newtonsewingstudio-star/ayab-hardware/ayab-esp32/KH910_REV_A_HALL_ASTAR_ROUTE.md

# Hall ADC A* route report

grid: 0.25 mm; track: 0.25 mm; obstacle expansion: 0.22 mm

## /ESP32/HALL_R_ADC
- start: (309.5, 160.5)
- goal: (218.8, 134.13)
- A* cells: 365
- simplified segments: 9
- points: (309.500,160.500) -> (307.750,160.500) -> (307.250,161.000) -> (288.250,161.000) -> (274.000,146.750) -> (235.250,146.750) -> (223.250,134.750) -> (219.000,134.750) -> (219.000,134.500) -> (218.800,134.130)

## /ESP32/HALL_L_ADC
- start: (94.0, 136.5)
- goal: (219.55, 134.13)
- A* cells: 506
- simplified segments: 5
- points: (94.000,136.500) -> (207.000,136.500) -> (210.000,133.500) -> (219.500,133.500) -> (219.500,134.000) -> (219.550,134.130)
