newtonsewingstudio-star/ayab-hardware/ayab-esp32/KH910_REV_A_12V_BUS_AUDIT.md

# KH910 Rev A — Existing +12 V Bus Audit

## All footprint pads currently on +12V

| Ref | Value | Pad | X | Y | Type |
|---|---|---:|---:|---:|---|
| C302 | 10u | 1 | 109.625 | 142.275 | SMD |
| C303 | 10u | 1 | 122.175 | 142.275 | SMD |
| C304 | 10u | 1 | 97.050 | 142.275 | SMD |
| C601 | 10u | 1 | 305.870 | 120.900 | SMD |
| C603 | 10u | 1 | 97.058 | 136.362 | SMD |
| C604 | 10u | 1 | 109.625 | 136.375 | SMD |
| C605 | 10u | 1 | 122.175 | 136.375 | SMD |
| C606 | 220u | 1 | 301.427 | 121.742 | TH |
| C607 | 220u | 1 | 333.720 | 126.740 | TH |
| C610 | 10u | 1 | 305.904 | 126.300 | SMD |
| D601 | KMB14F | 3 | 300.860 | 158.970 | SMD |
| J401 | 900.965.CK35 SOLENOIDS A | 10 | 114.840 | 153.785 | TH |
| J401 | 900.965.CK35 SOLENOIDS A | 9 | 116.840 | 153.785 | TH |
| J403 | 910.950 SOLENOIDS A | 10 | 308.410 | 138.830 | TH |
| J403 | 910.950 SOLENOIDS A | 9 | 310.910 | 138.830 | TH |
| J406 | 930.940 SOLENOIDS A | 10 | 116.740 | 146.280 | TH |
| J406 | 930.940 SOLENOIDS A | 9 | 119.240 | 146.280 | TH |
| J602 | Brother_5P | 2 | 60.900 | 100.920 | TH |
| J604 | Brother_4R | 1 | 343.950 | 166.165 | TH |
| R603 | 10k | 1 | 304.791 | 161.550 | SMD |
| TP601 | 12V | 1 | 305.320 | 149.980 | SMD |
| U302 | ULN2003A | 9 | 132.895 | 136.850 | SMD |
| U303 | ULN2003A | 9 | 120.345 | 136.850 | SMD |
| U304 | ULN2003A | 9 | 107.795 | 136.850 | SMD |
| U601 | XL1509 | 1 | 308.254 | 124.445 | SMD |

## +12V zones

- none

## +12V segment endpoints with degree 1 (possible branch/source ends)

- B.Cu (64.900,140.320)
- F.Cu (97.050,140.375)
- F.Cu (97.058,138.262)
- F.Cu (98.905,141.800)
- F.Cu (109.625,138.275)
- F.Cu (109.625,140.375)
- F.Cu (111.455,141.800)
- B.Cu (114.030,139.330)
- F.Cu (114.840,153.785)
- F.Cu (116.740,146.280)
- B.Cu (116.840,153.785)
- B.Cu (116.840,163.100)
- B.Cu (119.240,146.280)
- F.Cu (122.175,138.275)
- F.Cu (122.175,140.375)
- F.Cu (124.005,141.800)
- F.Cu (305.061,161.280)
- F.Cu (305.360,150.020)
- B.Cu (306.490,155.850)
- F.Cu (307.570,161.280)
- F.Cu (308.096,161.280)
- F.Cu (308.254,124.445)
- B.Cu (308.410,138.830)
- B.Cu (333.720,126.740)
- B.Cu (339.950,124.155)
