newtonsewingstudio-star/ayab-hardware/ayab-esp32/KH910_REV_A_SOLENOID_ROUTING_AUDIT.md

# KH910 Rev A — Solenoid Routing Audit

- max existing net number: **152**
- +12V segments: **90**
- +12V vias: **9**

## Target +12 V pads that must move to SOLENOID_12V_SW

| Ref | Pad | Global X | Global Y | Current net | Nearest +12V copper |
|---|---:|---:|---:|---|---:|
| J401 | 9 | 116.840 | 153.785 | `+12V` | 0.000 mm |
| J401 | 10 | 114.840 | 153.785 | `+12V` | 0.000 mm |
| J403 | 9 | 310.910 | 138.830 | `+12V` | 0.000 mm |
| J403 | 10 | 308.410 | 138.830 | `+12V` | 0.000 mm |
| J406 | 9 | 119.240 | 146.280 | `+12V` | 0.000 mm |
| J406 | 10 | 116.740 | 146.280 | `+12V` | 0.000 mm |
| U302 | 9 | 132.895 | 136.850 | `+12V` | 9.264 mm |
| U303 | 9 | 120.345 | 136.850 | `+12V` | 2.319 mm |
| U304 | 9 | 107.795 | 136.850 | `+12V` | 2.319 mm |

## +12V copper segments within 12 mm of any target pad

- `F.Cu` width 1.000: (117.910,139.320) -> (116.750,139.320)
- `F.Cu` width 0.250: (303.400,151.970) -> (305.320,150.050)
- `F.Cu` width 0.250: (305.320,150.050) -> (305.320,149.980)
- `F.Cu` width 0.250: (124.005,139.455) -> (123.870,139.320)
- `F.Cu` width 0.250: (122.175,139.335) -> (122.160,139.320)
- `F.Cu` width 1.000: (109.790,139.320) -> (99.120,139.320)
- `F.Cu` width 0.250: (109.625,139.485) -> (109.790,139.320)
- `F.Cu` width 1.270: (119.240,149.210) -> (119.240,146.280)
- `F.Cu` width 0.250: (111.455,139.375) -> (111.510,139.320)
- `F.Cu` width 1.270: (116.840,153.785) -> (116.840,151.610)
- `F.Cu` width 1.000: (117.950,139.320) -> (117.930,139.300)
- `F.Cu` width 1.000: (116.740,139.310) -> (116.730,139.320)
- `F.Cu` width 0.250: (97.058,138.920) -> (97.058,139.052)
- `F.Cu` width 0.250: (97.050,140.375) -> (97.050,138.928)
- `F.Cu` width 1.000: (99.120,139.320) -> (96.790,139.320)
- `F.Cu` width 1.000: (122.160,139.320) -> (117.950,139.320)
- `F.Cu` width 0.250: (97.050,138.928) -> (97.058,138.920)
- `F.Cu` width 1.000: (116.750,139.320) -> (116.740,139.310)
- `F.Cu` width 0.250: (122.175,140.375) -> (122.175,139.335)
- `F.Cu` width 0.250: (97.058,138.262) -> (97.058,138.920)
- `F.Cu` width 1.270: (116.740,146.280) -> (119.240,146.280)
- `F.Cu` width 0.250: (109.625,138.275) -> (109.625,139.155)
- `F.Cu` width 1.000: (114.390,139.320) -> (111.510,139.320)
- `F.Cu` width 1.000: (117.930,139.300) -> (117.910,139.320)
- `F.Cu` width 0.250: (305.320,149.980) -> (305.360,150.020)
- `F.Cu` width 0.250: (122.175,138.275) -> (122.175,139.305)
- `F.Cu` width 1.270: (116.840,151.610) -> (119.240,149.210)
- `F.Cu` width 1.000: (116.730,139.320) -> (115.600,139.320)
- `F.Cu` width 1.000: (123.870,139.320) -> (122.160,139.320)
- `F.Cu` width 1.000: (115.600,139.320) -> (114.390,139.320)
- `F.Cu` width 1.270: (116.840,153.785) -> (114.840,153.785)
- `F.Cu` width 0.250: (109.625,139.155) -> (109.790,139.320)
- `F.Cu` width 0.250: (122.175,139.305) -> (122.160,139.320)
- `F.Cu` width 0.250: (109.625,140.375) -> (109.625,139.485)
- `F.Cu` width 1.000: (111.510,139.320) -> (109.790,139.320)
- `F.Cu` width 0.250: (97.058,139.052) -> (96.790,139.320)
- `F.Cu` width 0.250: (124.005,141.800) -> (124.005,139.455)
- `F.Cu` width 0.250: (98.905,141.800) -> (98.905,139.535)
- `F.Cu` width 0.250: (98.905,139.535) -> (99.120,139.320)
- `F.Cu` width 0.250: (111.455,141.800) -> (111.455,139.375)
- `B.Cu` width 2.000: (310.910,138.830) -> (308.410,138.830)
- `B.Cu` width 1.270: (116.840,153.785) -> (116.840,163.100)
- `B.Cu` width 1.270: (118.470,139.330) -> (114.030,139.330)
- `B.Cu` width 1.270: (119.243,140.103) -> (118.470,139.330)
- `B.Cu` width 1.270: (70.500,163.100) -> (303.530,163.100)
- `B.Cu` width 1.270: (334.160,141.850) -> (312.450,141.850)
- `B.Cu` width 1.270: (119.243,146.277) -> (119.243,140.103)
- `B.Cu` width 1.270: (312.450,141.850) -> (310.910,140.310)
- `B.Cu` width 1.270: (119.240,146.280) -> (119.243,146.277)
- `B.Cu` width 1.270: (310.910,140.310) -> (310.910,138.830)

## Existing +12V vias near target pads

- via (117.930,139.300) size 0.800 drill 0.400
- via (115.600,139.320) size 0.800 drill 0.400
- via (114.390,139.320) size 0.800 drill 0.400
- via (116.740,139.310) size 0.800 drill 0.400

## Existing MOSFET footprint templates

### Q201 — AO3400A / C20917
- footprint `Package_TO_SOT_SMD:SOT-23` at (240.7725, 152.37, 0.0)
- pad 1 global (239.835,151.420) net `/ESP32/BUZZER`
- pad 2 global (239.835,153.320) net `GND`
- pad 3 global (241.710,152.370) net `Net-(Q201-D)`

### Q502 — LP9435LT1G / C383257
- footprint `Package_TO_SOT_SMD:SOT-23` at (258.45, 154.035, 90.0)
- pad 1 global (259.400,153.097) net `Net-(Q501B-C2)`
- pad 2 global (257.500,153.097) net `+5V`
- pad 3 global (258.450,154.972) net `Net-(Q501A-E1)`

### Q801 — AO3400A / C20917
- footprint `Package_TO_SOT_SMD:SOT-23` at (275.5746, 155.0175, -90.0)
- pad 1 global (274.625,155.955) net `+3V3`
- pad 2 global (276.525,155.955) net `Net-(Q801-S)`
- pad 3 global (275.575,154.080) net `/AUX-CONNECTORS/AUX_SCL`

### Q802 — AO3400A / C20917
- footprint `Package_TO_SOT_SMD:SOT-23` at (280.615, 155.0475, -90.0)
- pad 1 global (279.665,155.985) net `+3V3`
- pad 2 global (281.565,155.985) net `Net-(Q802-S)`
- pad 3 global (280.615,154.110) net `/AUX-CONNECTORS/AUX_SDA`

### Q803 — AO3400A / C20917
- footprint `Package_TO_SOT_SMD:SOT-23` at (94.23, 127.32, 90.0)
- pad 1 global (95.180,126.382) net `+3V3`
- pad 2 global (93.280,126.382) net `Net-(Q803-S)`
- pad 3 global (94.230,128.257) net `/AUX-CONNECTORS/MCP_SCL`

### Q804 — AO3400A / C20917
- footprint `Package_TO_SOT_SMD:SOT-23` at (97.75, 127.33, 90.0)
- pad 1 global (98.700,126.392) net `+3V3`
- pad 2 global (96.800,126.392) net `Net-(Q804-S)`
- pad 3 global (97.750,128.267) net `/AUX-CONNECTORS/MCP_SDA`

## New schematic device paths

- Q805: `/ad16b75f-afc8-4717-a7c6-8dd7b69a18e2/5c12a608-dfd1-46fe-96db-4ec512a20774`
- Q806: `/ad16b75f-afc8-4717-a7c6-8dd7b69a18e2/5c12a608-dfd1-46fe-96db-4ec512a20774`
- R820: `/ad16b75f-afc8-4717-a7c6-8dd7b69a18e2/5c12a608-dfd1-46fe-96db-4ec512a20774`
- R821: `/ad16b75f-afc8-4717-a7c6-8dd7b69a18e2/5c12a608-dfd1-46fe-96db-4ec512a20774`
- R822: `/ad16b75f-afc8-4717-a7c6-8dd7b69a18e2/5c12a608-dfd1-46fe-96db-4ec512a20774`

## Coarse board edge bounds

- X: 60.224 .. 345.346
- Y: 116.112 .. 164.214
