newtonsewingstudio-star/ayab-hardware/firmware/stage5/BETA_STATUS.md

# Stage 5 beta — ESP32-S3 KH910 Rev A

Status: **experimental development snapshot, not machine-ready**.

Source hardware: `newtonsewingstudio-star/ayab-hardware` commit `ae8f7eb`.

This directory contains an exact source and test backup of the Stage 5 working archive. There are 20 original project files: the PlatformIO project file, 6 `src/` files, 8 `tests/` files, and 5 project documentation files. The snapshot has protocol and simulation tests, but does **not** have a verified ESP32-S3 target build or validated hardware drivers. All machine-output functionality must remain disabled until electrical and physical safety checks are completed.

See `BUILD_STATUS.md` and `BENCH_TEST_PLAN.md` before bench testing. GitHub files were individually checked against the local Stage 5 snapshot using Git blob SHA-1 checksums.
