newtonsewingstudio-star/ayab-hardware/ayab-esp32/review/KH910_REV_A_AUDIT_ROUND_2.md

# AYAB KH910 Rev A — External Audit Round 2 Record

Review input: external static review of the `09fa402` handoff package.

Record status: structured author-maintained summary of the auditor's response. It is not represented as a verbatim transcript or as an independently executed KiCad review.

## Package integrity

- The auditor re-verified all 222 entries in `MANIFEST_SHA256.txt`; every file hash matched.
- No tamper evidence was found.
- The auditor could not independently reach the GitHub repository or CI runs from the available environment, so the packaged CI evidence remains self-supplied from the auditor's perspective.

## Prior findings

| Finding | Round 2 assessment |
|---|---|
| P1: GPIO4 exposed if R216 opens | Closed. D205/D206/C206 and R215 were confirmed in the schematic, and the clamp-current limits were accepted as sound for the prototype scope. |
| P1: divider transient margin thin | Closed for prototype scope. Ordinary positive and negative excursions are bounded, while surge certification and stated residual faults remain explicitly excluded. |
| P2: solenoid-gate fault tree incomplete | Closed. All eleven requested component/control fault cases and the unsafe residuals are enumerated. |
| P2: I/O-map authority conflict | Closed. The prose map is explicitly subordinate to native KiCad and the generated pin audit. |
| P3: iterative tooling/self-audit provenance | Acknowledged and mitigated, not erased. Independent re-derivation remains important. |
| P3: PASS wording could be misread | Closed editorially. The design-review verdict retains its one-prototype, supervised-bring-up, and non-certification limits. |

## New documentation correction

The prior handoff described `AUDITOR_NOTES_e3dd936.md` as preserving the preliminary review “verbatim.” It was a paraphrased and restructured summary. This record and all refreshed handoff materials describe it accurately as a faithful structured summary.

## Remaining gates

1. Before fabrication: an independent reviewer with KiCad must reproduce DRC, ERC, pin-map, topology, and parity checks from the native source. The author-generated CI evidence does not substitute for that independent run.
2. After assembly and before any solenoid is attached or operated: perform the documented rail, isolation, ADC/transient, reset/brownout, current, and thermal measurements.

No fabrication files were produced for this audit cycle.
