newtonsewingstudio-star/ayab-hardware/ayab-esp32/review/KH910_REV_A_POWER_LAYOUT.md

# KH910 Rev A — Power PCB Placement Preflight

Read-only KiCad-native inventory used before adding U403 and R215/R216.

## Existing power-stage footprints and pads

### C612 — `220u` at (301.504, 129.134)
- pad 1 (301.504, 129.134): `/PSU/5V_SW`
- pad 2 (299.004, 129.134): `GND`

### C613 — `220u` at (268.260, 128.930)
- pad 1 (268.260, 128.930): `/PSU/3V3_SW`
- pad 2 (265.760, 128.930): `GND`

### C614 — `3n3` at (307.920, 130.620)
- pad 1 (307.920, 129.845): `Net-(U601-FB)`
- pad 2 (307.920, 131.395): `/PSU/5V_SW`

### C615 — `3n3` at (274.660, 130.630)
- pad 1 (274.660, 129.855): `Net-(U602-FB)`
- pad 2 (274.660, 131.405): `/PSU/3V3_SW`

### C616 — `10u` at (313.740, 130.830)
- pad 1 (313.740, 131.780): `/PSU/5V_SW`
- pad 2 (313.740, 129.880): `GND`

### C617 — `10u` at (280.560, 130.840)
- pad 1 (280.560, 131.790): `/PSU/3V3_SW`
- pad 2 (280.560, 129.890): `GND`

### C618 — `10u` at (311.720, 130.830)
- pad 1 (311.720, 131.780): `/PSU/5V_SW`
- pad 2 (311.720, 129.880): `GND`

### C619 — `10u` at (278.510, 130.840)
- pad 1 (278.510, 131.790): `/PSU/3V3_SW`
- pad 2 (278.510, 129.890): `GND`

### C620 — `10u` at (309.690, 130.840)
- pad 1 (309.690, 131.790): `/PSU/5V_SW`
- pad 2 (309.690, 129.890): `GND`

### C621 — `10u` at (276.460, 130.850)
- pad 1 (276.460, 131.800): `/PSU/3V3_SW`
- pad 2 (276.460, 129.900): `GND`

### D605 — `SS54` at (311.054, 121.800)
- pad 1 (313.054, 121.800): `Net-(D605-K)`
- pad 2 (309.054, 121.800): `GND`

### D606 — `SS54` at (278.059, 121.800)
- pad 1 (280.059, 121.800): `Net-(D606-K)`
- pad 2 (276.059, 121.800): `GND`

### L601 — `47uH` at (321.380, 126.320)
- pad 1 (321.380, 121.370): `Net-(D605-K)`
- pad 2 (321.380, 131.270): `/PSU/5V_SW`

### L602 — `47uH` at (288.284, 126.325)
- pad 1 (288.284, 121.375): `Net-(D606-K)`
- pad 2 (288.284, 131.275): `/PSU/3V3_SW`

### R606 — `1k` at (304.830, 130.620)
- pad 1 (304.830, 131.445): `Net-(U601-FB)`
- pad 2 (304.830, 129.795): `GND`

### R607 — `1k` at (271.570, 130.630)
- pad 1 (271.570, 131.455): `Net-(U602-FB)`
- pad 2 (271.570, 129.805): `GND`

### R608 — `3k3` at (306.380, 130.620)
- pad 1 (306.380, 129.795): `Net-(U601-FB)`
- pad 2 (306.380, 131.445): `/PSU/5V_SW`

### R609 — `1k8` at (273.110, 130.630)
- pad 1 (273.110, 129.805): `Net-(U602-FB)`
- pad 2 (273.110, 131.455): `/PSU/3V3_SW`

### R610 — `0R` at (276.950, 134.870)
- pad 1 (276.125, 134.870): `/PSU/3V3_SW`
- pad 2 (277.775, 134.870): `+3V3`

- R611: **missing**
### TP602 — `5V` at (306.863, 134.518)
- pad 1 (306.863, 134.518): `/PSU/5V_SW`

### TP603 — `3V3` at (273.837, 134.518)
- pad 1 (273.837, 134.518): `/PSU/3V3_SW`

### U601 — `XL1509` at (310.729, 126.350)
- pad 1 (308.254, 124.445): `+12V`
- pad 2 (308.254, 125.715): `Net-(D605-K)`
- pad 3 (308.254, 126.985): `Net-(U601-FB)`
- pad 4 (308.254, 128.255): `GND`
- pad 5 (313.204, 128.255): `GND`
- pad 6 (313.204, 126.985): `GND`
- pad 7 (313.204, 125.715): `GND`
- pad 8 (313.204, 124.445): `GND`

### U602 — `XL1509` at (277.859, 126.330)
- pad 1 (275.384, 124.425): `+5V`
- pad 2 (275.384, 125.695): `Net-(D606-K)`
- pad 3 (275.384, 126.965): `Net-(U602-FB)`
- pad 4 (275.384, 128.235): `GND`
- pad 5 (280.334, 128.235): `GND`
- pad 6 (280.334, 126.965): `GND`
- pad 7 (280.334, 125.695): `GND`
- pad 8 (280.334, 124.425): `GND`

## Existing GPIO4 branch to be removed

- U201 pad 8 / GPIO4 at (217.125, 129.675): `/ESP32/MACHINE_PWR_SENSE`
- Routed items ending directly at that pad:
  - `/ESP32/MACHINE_PWR_SENSE` F.Cu (209.785, 129.675) -> (217.125, 129.675)

## Nearby placement inventory

### Within 18 mm of U201 at (224.125, 129.675)
- 11.20 mm: R818 `47R` at (235.325, 129.910)
- 11.28 mm: R208 `10k` at (235.325, 128.350)
- 11.33 mm: R819 `47R` at (235.315, 131.460)
- 11.51 mm: R206 `10k` at (212.750, 127.950)
- 11.57 mm: R207 `10k` at (235.325, 126.775)
- 11.62 mm: R210 `5k1` at (212.750, 132.025)
- 11.77 mm: C201 `100n` at (235.300, 133.370)
- 11.84 mm: C203 `100n` at (212.750, 126.400)
- 12.06 mm: R209 `5k1` at (212.750, 133.675)
- 12.06 mm: C202 `100n` at (235.325, 125.200)
- 12.34 mm: R201 `10k` at (235.300, 134.920)
- 12.35 mm: C204 `100n` at (212.750, 124.875)
- 12.70 mm: R814 `10k` at (212.750, 135.325)
- 12.71 mm: R205 `10k` at (235.320, 123.650)
- 13.35 mm: C205 `10u` at (212.525, 123.075)
- 13.52 mm: R813 `47R` at (212.750, 136.975)
- 14.46 mm: R815 `10k` at (212.750, 138.600)
- 14.84 mm: D201 `LED_YEL` at (238.692, 132.490)
- 15.40 mm: D202 `LED_GRN` at (238.692, 134.680)
- 16.26 mm: D203 `LED_RED` at (238.692, 136.890)
- 17.15 mm: FID102 `Fiducial` at (240.990, 126.580)

### Within 18 mm of U601 at (310.729, 126.350)
- 4.56 mm: D605 `SS54` at (311.054, 121.800)
- 4.59 mm: C618 `10u` at (311.720, 130.830)
- 4.61 mm: C620 `10u` at (309.690, 130.840)
- 4.93 mm: C610 `10u` at (305.904, 125.350)
- 5.11 mm: C614 `3n3` at (307.920, 130.620)
- 5.40 mm: C616 `10u` at (313.740, 130.830)
- 6.10 mm: R608 `3k3` at (306.380, 130.620)
- 6.62 mm: C601 `10u` at (305.870, 121.850)
- 7.03 mm: R604 `5k1` at (310.120, 133.350)
- 7.28 mm: R606 `1k` at (304.830, 130.620)
- 7.42 mm: D603 `5VOK` at (313.160, 133.360)
- 9.04 mm: TP602 `5V` at (306.863, 134.518)
- 9.64 mm: C612 `220u` at (301.504, 129.134)
- 10.17 mm: kibuzzard-659F49E4 `G***` at (304.673, 134.518)
- 10.38 mm: C606 `220u` at (301.427, 121.742)
- 10.65 mm: L601 `47uH` at (321.380, 126.320)
- 14.44 mm: kibuzzard-65BFD836 `G***` at (322.150, 135.180)
- 16.11 mm: J403 `910.950 SOLENOIDS A` at (320.910, 138.830)

## Required staged edits

- Place U403 adjacent to the U601 filtered-output cluster, then partition only that output from the existing +5V copper.
- Place R215/R216 beside U201 GPIO4, route the divider locally, and leave the high-voltage +12V segment away from USB/data routing.
- Refill zones and prove DRC, connectivity, and the power-state topology before promotion.
