newtonsewingstudio-star/ayab-hardware/ayab-esp32/KH910_REV_A_FAILSAFE_LAYOUT_AUDIT.md

# KH910 Rev A — Fail-Safe Layout Corridor Audit

## Right-side placement region (X 260..320, Y 145..162)

- R807 `5k1` at (273.065,155.475) rot 90
- J405 `910.950 ENCODERS EOL R` at (280.930,145.170) rot 180
- TP401 `9` at (270.930,149.150) rot 0
- TP402 `10` at (268.420,149.140) rot 0
- R734 `47k` at (313.120,157.250) rot 90
- R730 `4k7` at (311.570,157.250) rot -90
- J601 `VIN` at (292.105,156.085) rot 90
- kibuzzard-65C3D944 `G***` at (307.380,149.980) rot 0
- FID106 `Fiducial` at (266.540,153.040) rot 0
- R801 `47R` at (273.065,152.425) rot -90
- R721 `10k` at (313.120,154.200) rot 90
- R804 `5k1` at (275.375,152.280) rot 0
- R803 `5k1` at (280.390,152.310) rot 180
- Q802 `AO3400A` at (280.615,155.048) rot -90
- Q801 `AO3400A` at (275.575,155.018) rot -90
- R729 `3k3` at (311.570,154.200) rot -90
- D601 `KMB14F` at (302.130,156.150) rot 90
- kibuzzard-659F41CB `G***` at (269.850,160.230) rot 0
- J802 `I2C_VBUS` at (281.500,159.360) rot -90
- R808 `5k1` at (278.090,155.485) rot 90
- R732 `22k` at (314.670,157.250) rot -90
- U703 `LM393` at (319.195,155.400) rot 0
- J803 `USER_I2C` at (276.250,160.335) rot 0
- TP601 `12V` at (305.320,149.980) rot -90
- kibuzzard-65A1ADEE `G***` at (318.240,160.160) rot 0
- R717 `100k` at (314.670,154.200) rot -90
- R802 `47R` at (278.090,152.435) rot -90
- R603 `10k` at (303.966,161.550) rot 180

## Pads currently on GPIO21 PCB net 148

- J202 pad 4 at (119.000,120.300) `/ESP32/ESP21`
- U201 pad 25 at (225.825,136.675) `/ESP32/ESP21`

## Solenoid-sheet +12V pads expected to become switched

- C303 pad 1 at (122.175,142.275)
- U304 pad 9 at (107.795,136.850)
- U303 pad 9 at (120.345,136.850)
- C302 pad 1 at (109.625,142.275)
- J401 pad 9 at (116.840,153.785)
- J401 pad 10 at (114.840,153.785)
- J406 pad 9 at (119.240,146.280)
- J406 pad 10 at (116.740,146.280)
- J403 pad 9 at (310.910,138.830)
- J403 pad 10 at (308.410,138.830)
- U302 pad 9 at (132.895,136.850)
- C304 pad 1 at (97.050,142.275)

## Copper in proposed switched-bus corridor (X 90..320, Y 158.5..162.2)

- F.Cu net 2 w 0.250: (161.840,159.750)->(161.860,159.730)
- F.Cu net 2 w 0.250: (161.860,159.730)->(161.860,157.115)
- F.Cu net 4 w 1.270: (306.490,159.020)->(306.490,155.850)
- F.Cu net 4 w 1.270: (306.490,160.160)->(306.490,159.060)
- F.Cu net 4 w 1.270: (308.160,161.870)->(309.310,163.020)
- F.Cu net 4 w 0.250: (308.096,161.280)->(305.061,161.280)
- F.Cu net 4 w 1.270: (308.160,161.870)->(306.470,160.180)
- F.Cu net 4 w 1.270: (306.490,159.060)->(306.470,159.040)
- F.Cu net 4 w 1.270: (306.470,160.180)->(306.490,160.160)
- F.Cu net 4 w 1.270: (308.160,161.870)->(307.570,161.280)
- F.Cu net 4 w 1.270: (306.470,159.040)->(306.490,159.020)
- B.Cu net 4 w 1.270: (306.490,160.140)->(306.490,155.850)
- B.Cu net 4 w 1.270: (116.840,153.785)->(116.840,163.100)
- B.Cu net 4 w 1.270: (303.530,163.100)->(306.490,160.140)
- F.Cu net 5 w 0.250: (281.500,160.660)->(283.110,160.660)
- F.Cu net 5 w 0.250: (182.809,161.159)->(182.810,161.160)
- F.Cu net 5 w 0.250: (181.713,161.159)->(182.809,161.159)
- F.Cu net 5 w 0.250: (182.810,159.590)->(182.758,159.538)
- F.Cu net 5 w 0.250: (182.758,159.538)->(181.713,159.538)
- In2.Cu net 5 w 1.000: (181.420,162.550)->(182.810,161.160)
- In2.Cu net 5 w 1.000: (284.610,159.160)->(284.610,151.670)
- In2.Cu net 5 w 1.000: (163.840,159.750)->(166.640,162.550)
- In2.Cu net 5 w 1.000: (268.100,160.660)->(283.110,160.660)
- In2.Cu net 5 w 1.000: (283.110,160.660)->(284.610,159.160)
- In2.Cu net 5 w 1.000: (259.410,151.970)->(268.100,160.660)
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
- F.Cu w 1.270: (305.360,153.690)->(306.490,154.820)
- F.Cu w 1.270: (305.030,153.360)->(305.360,153.690)
- F.Cu w 1.270: (306.470,159.040)->(306.490,159.020)
- B.Cu w 1.270: (306.490,160.140)->(306.490,155.850)
- B.Cu w 1.270: (303.530,163.100)->(306.490,160.140)
