newtonsewingstudio-star/ayab-hardware/ayab-esp32/KH910_REV_A_HALL_LEGACY_ROUTES.md

# KH910 Rev A — Legacy Hall Route Audit

Total items: **26**

The baseline PCB is DRC-clean. These are the exact legacy EOL_L_P/EOL_L_N copper items before Hall migration.

## /ESP32/EOL_L_P — 12 items

1. `F.Cu` segment (219.55, 128.83) -> (217.845, 127.125)
2. `F.Cu` segment (217.845, 127.125) -> (217.125, 127.125)
3. `F.Cu` segment (212.04, 156.36) -> (213.824898, 156.36)
4. `F.Cu` segment (210.545, 157.855) -> (212.04, 156.36)
5. `F.Cu` segment (213.824898, 156.36) -> (215.127498, 155.0574)
6. `F.Cu` segment (197.2025, 157.855) -> (210.545, 157.855)
7. `F.Cu` segment (219.55, 134.13) -> (219.55, 128.83)
8. `B.Cu` segment (218.72, 135.79) -> (218.72, 151.464898)
9. `B.Cu` segment (218.72, 151.464898) -> (215.127498, 155.0574)
10. `B.Cu` segment (219.55, 134.96) -> (218.72, 135.79)
11. `B.Cu` segment (219.55, 134.13) -> (219.55, 134.96)
12. `F.Cu-B.Cu` via at (219.55, 134.13)

### MCU-near subset (x >= 205 or y <= 145)

- item 1: `F.Cu` segment (219.55, 128.83) -> (217.845, 127.125)
- item 2: `F.Cu` segment (217.845, 127.125) -> (217.125, 127.125)
- item 3: `F.Cu` segment (212.04, 156.36) -> (213.824898, 156.36)
- item 4: `F.Cu` segment (210.545, 157.855) -> (212.04, 156.36)
- item 5: `F.Cu` segment (213.824898, 156.36) -> (215.127498, 155.0574)
- item 6: `F.Cu` segment (197.2025, 157.855) -> (210.545, 157.855)
- item 7: `F.Cu` segment (219.55, 134.13) -> (219.55, 128.83)
- item 8: `B.Cu` segment (218.72, 135.79) -> (218.72, 151.464898)
- item 9: `B.Cu` segment (218.72, 151.464898) -> (215.127498, 155.0574)
- item 10: `B.Cu` segment (219.55, 134.96) -> (218.72, 135.79)
- item 11: `B.Cu` segment (219.55, 134.13) -> (219.55, 134.96)
- item 12: `F.Cu-B.Cu` via at (219.55, 134.13)

## /ESP32/EOL_L_N — 14 items

1. `F.Cu` segment (218.8, 128.93) -> (217.845, 127.975)
2. `F.Cu` segment (218.8, 134.13) -> (218.8, 128.93)
3. `F.Cu` segment (197.2025, 158.505) -> (211.679898, 158.505)
4. `F.Cu` segment (217.845, 127.975) -> (217.125, 127.975)
5. `F.Cu` segment (211.679898, 158.505) -> (212.587498, 157.5974)
6. `B.Cu` segment (218.47, 135.63) -> (218.47, 151.041244)
7. `B.Cu` segment (218.47, 151.041244) -> (215.731244, 153.78)
8. `B.Cu` segment (213.88, 156.304898) -> (212.587498, 157.5974)
9. `B.Cu` segment (213.88, 154.43) -> (213.88, 156.304898)
10. `B.Cu` segment (215.731244, 153.78) -> (214.53, 153.78)
11. `B.Cu` segment (218.8, 134.13) -> (218.8, 135.3)
12. `B.Cu` segment (218.8, 135.3) -> (218.47, 135.63)
13. `B.Cu` segment (214.53, 153.78) -> (213.88, 154.43)
14. `F.Cu-B.Cu` via at (218.8, 134.13)

### MCU-near subset (x >= 205 or y <= 145)

- item 1: `F.Cu` segment (218.8, 128.93) -> (217.845, 127.975)
- item 2: `F.Cu` segment (218.8, 134.13) -> (218.8, 128.93)
- item 3: `F.Cu` segment (197.2025, 158.505) -> (211.679898, 158.505)
- item 4: `F.Cu` segment (217.845, 127.975) -> (217.125, 127.975)
- item 5: `F.Cu` segment (211.679898, 158.505) -> (212.587498, 157.5974)
- item 6: `B.Cu` segment (218.47, 135.63) -> (218.47, 151.041244)
- item 7: `B.Cu` segment (218.47, 151.041244) -> (215.731244, 153.78)
- item 8: `B.Cu` segment (213.88, 156.304898) -> (212.587498, 157.5974)
- item 9: `B.Cu` segment (213.88, 154.43) -> (213.88, 156.304898)
- item 10: `B.Cu` segment (215.731244, 153.78) -> (214.53, 153.78)
- item 11: `B.Cu` segment (218.8, 134.13) -> (218.8, 135.3)
- item 12: `B.Cu` segment (218.8, 135.3) -> (218.47, 135.63)
- item 13: `B.Cu` segment (214.53, 153.78) -> (213.88, 154.43)
- item 14: `F.Cu-B.Cu` via at (218.8, 134.13)
