newtonsewingstudio-star/ayab-hardware/ayab-esp32/review/KH910_REV_A_BOTTOM.png

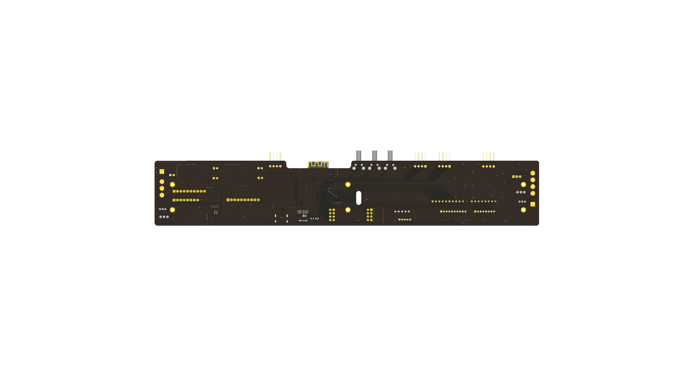
ayab-esp32/review/KH910_REV_A_BOTTOM.png
