newtonsewingstudio-star/ayab-hardware/ayab-esp32/review/KH910_REV_A_BOTTOM_COPPER.png

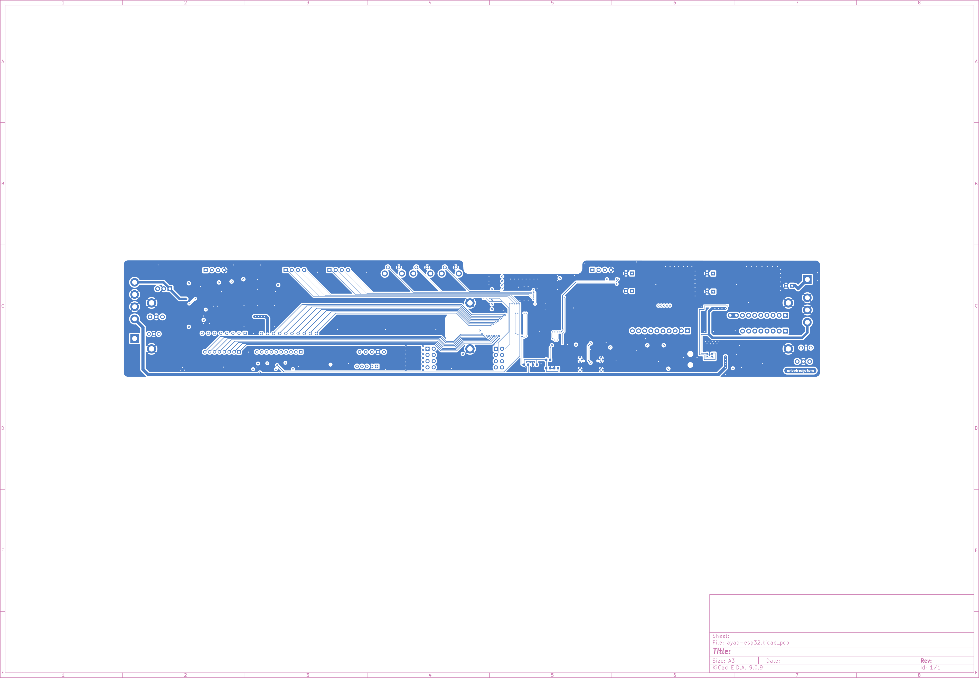
ayab-esp32/review/KH910_REV_A_BOTTOM_COPPER.png
