newtonsewingstudio-star/ayab-hardware/ayab-esp32/ayab-esp32.kicad_pcb

## KiCad design ayab-esp32/ayab-esp32.kicad_pcb (2026-09-15)

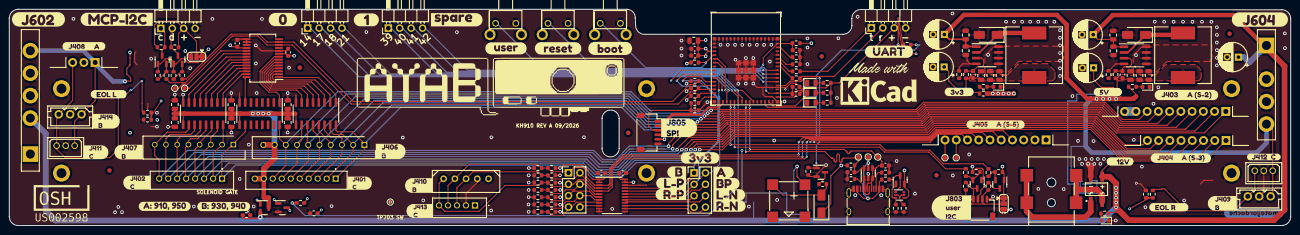
[picture p3: board ayab-esp32.kicad_pcb from above]

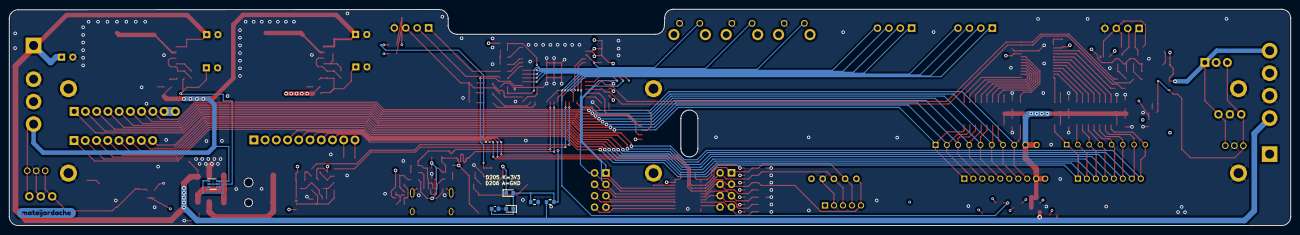
[picture p4: board ayab-esp32.kicad_pcb from below]

Board: 4 copper layers, 285.1 x 48.1 mm, 235 parts (7 on the bottom side), 128 nets.

Parts:
BUZZER201: MLT-8530; BUZ-SMD_4P-L8.5-W8.5-P8.50-BR
C201, C202, C203, C204, C206, C301, C305, C701, C702: 100n; C_0603_1608Metric
C205, C302, C303, C304, C601, C602, C603, C604, C605, C610, C611, C616, C617, C618, C619, C620, C621: 10u; C_0805_2012Metric
C501, C502: 47p; C_0603_1608Metric
C606, C607, C609, C612, C613: 220u; CP_Radial_D6.3mm_P2.50mm
C614, C615: 3n3; C_0603_1608Metric
D201: LED_YEL; D_0805_2012Metric
D202: LED_GRN; D_0805_2012Metric
D203: LED_RED; D_0805_2012Metric
D204, D605, D606: SS54; D_SMA
D205, D206: CDBU0130-HF; D_0603_1608Metric
D601: KMB14F; MBF-SMD_L4.8-W3.8-P2.54-LS6.8-TL
D602: 12VOK; D_0603_1608Metric
D603: 5VOK; D_0603_1608Metric
D604: 3V3OK; D_0603_1608Metric
FID101, FID102, FID103, FID104, FID105, FID106: Fiducial; Fiducial_1mm_Mask2mm
H101, H102, H103, H104, H106, H108: M2; MountingHole_2.2mm_M2_DIN965_Pad
J201: SPARE1; PinHeader_1x04_P2.54mm_Horizontal
J202: SPARE0; PinHeader_1x04_P2.54mm_Horizontal
J401: 900.965.CK35 SOLENOIDS A; 530141010
J402: 900.965.CK35 SOLENOIDS B; 530140810
J403: 910.950 SOLENOIDS A; HNC2-2.5P-10DS
J404: 910.950 SOLENOIDS B; HNC2-2.5P-8DS
J405: 910.950 ENCODERS EOL R; HNC2-2.5P-10DS
J406: 930.940 SOLENOIDS A; SHDR10W70P0X250_1X10_2740X490X590P
J407: 930.940 SOLENOIDS B; SHDR8W65P0X250_1X8_2240X490X610P
J408: 910.950 EOL L; HNC2-2.5P-3DS
J409: 930.940 EOL R; CONN-TH_3P-P2.50_X2564WV-03-N0SN
J410: 930.940 ENCODERS; CONN-TH_X2564WV-05-N0SN
J411: 900.965 EOL L; CONN-TH_3P-P2.00_A2004WV-3P
J412: 900.965 EOL R; CONN-TH_3P-P2.00_A2004WV-3P
J413: 900.965 ENCODERS; 530140510
J414: 930.940 EOL L; CONN-TH_3P-P2.50_X2564WV-03-N0SN
J501: USB_C_Receptacle_USB2.0; USB_C_Receptacle_HRO_TYPE-C-31-M-12
J601: VIN; DC-IN-TH_DC-005-5A-2.0-SMT
J602: Brother_5P
J604: Brother_4R; Brother_4P
J701: CTRL_3v3; PinHeader_2x04_P2.54mm_Vertical
J702: CTRL_5V; PinHeader_2x04_P2.54mm_Vertical
J801: AYAB_UART; PinHeader_1x04_P2.54mm_Horizontal
J802, J804: I2C_VBUS; SolderJumper-3_P1.3mm_Bridged12_RoundedPad1.0x1.5mm
J803: USER_I2C; JST_SH_SM04B-SRSS-TB_1x04-1MP_P1.00mm_Horizontal
J805: AYAB_SPI; JST_SH_SM06B-SRSS-TB_1x06-1MP_P1.00mm_Horizontal
J806: AYAB_I2C; PinHeader_1x04_P2.54mm_Horizontal
L601, L602: 47uH; L_12x12mm_H8mm
Q201, Q801, Q802, Q803, Q804, Q806: AO3400A; SOT-23
Q501: BCM857BV; SOT-363_SC-70-6
Q502, Q805: LP9435LT1G; SOT-23
R101, R102, R202, R203, R204, R209, R210, R604, R803, R804, R807, R808, R811, R812, R816, R817: 5k1; R_0603_1608Metric
R201, R205, R206, R207, R208, R211, R213, R214, R216, R603, R701, R702, R703, R704, R705, R706, R707, R708, R709, R710, R711, R712, R713, R714, R735, R736, R737, R738, R814, R815, R821: 10k; R_0603_1608Metric
R212, R504, R610: 0R; R_0603_1608Metric
R215: 47k; R_0603_1608Metric
R501: 1k5; R_0603_1608Metric
R502, R820, R822: 100k; R_0603_1608Metric
R503: 68k; R_0603_1608Metric
R605, R608: 3k3; R_0603_1608Metric
R606, R607: 1k; R_0603_1608Metric
R609: 1k8; R_0603_1608Metric
R801, R802, R809, R810, R813, R818, R819: 47R; R_0603_1608Metric
SW201: USER; KEY-TH_4P-L7.5-W11.5-P4.5
SW202: RESET; KEY-TH_4P-L7.5-W11.5-P4.5
SW203: BOOTSEL; KEY-TH_4P-L7.5-W11.5-P4.5
TP301: MCP_INTA; TestPoint_Pad_D1.0mm
TP302: MCP_INTB; TestPoint_Pad_D1.0mm
TP401: 9; TestPoint_Pad_D1.0mm
TP402: 10; TestPoint_Pad_D1.0mm
TP501: USB_BUSV; TestPoint_Pad_D1.0mm
TP502: USBM; TestPoint_Pad_D1.0mm
TP503: USBP; TestPoint_Pad_D1.0mm
TP601: 12V; TestPoint_Pad_D1.0mm
TP602: 5V; TestPoint_Pad_D1.0mm
TP603: 3V3; TestPoint_Pad_D1.0mm
TP701: HALL-L-RAW; TestPoint_Pad_D1.0mm
TP702: HALL-R-RAW; TestPoint_Pad_D1.0mm
TP703: SOL12_SW; TestPoint_Pad_D1.0mm
U201: ESP32-S3-MINI-1
U301: MCP23017_SS; SSOP-28_5.3x10.2mm_P0.65mm
U302, U303, U304: ULN2003A; SOIC-16_3.9x9.9mm_P1.27mm
U403: LM66100DCKR; SOT-363_SC-70-6
U501: SRV05-4; SOT-23-6
U601, U602: XL1509; SOIC-8_3.9x4.9mm_P1.27mm
U701: SN74LVC4245; TSSOP-24_4.4x7.8mm_P0.65mm
kibuzzard-64F68412: G***; kibuzzard-64F68412
kibuzzard-65A1AC88: G***; kibuzzard-65A1AC88
kibuzzard-65A1ADEE: G***; kibuzzard-65A1ADEE
kibuzzard-65A1DFCB: G***; kibuzzard-65A1DFCB
kibuzzard-65A2E0AA: G***; kibuzzard-65A2E0AA
kibuzzard-65A2E6F1: G***; kibuzzard-65A2E6F1
kibuzzard-65A2E096: G***; kibuzzard-65A2E096
kibuzzard-65A40139: G***; kibuzzard-65A40139
kibuzzard-65BC6282: G***; kibuzzard-65BC6282
kibuzzard-65BFAF9E: G***; kibuzzard-65BFAF9E
kibuzzard-65BFB941: G***; kibuzzard-65BFB941
kibuzzard-65BFD8A4: G***; kibuzzard-65BFD8A4
kibuzzard-65BFD8C0: G***; kibuzzard-65BFD8C0
kibuzzard-65BFD8D6: G***; kibuzzard-65BFD8D6
kibuzzard-65BFD8DF: G***; kibuzzard-65BFD8DF
kibuzzard-65BFD8F7: G***; kibuzzard-65BFD8F7
kibuzzard-65BFD82E: G***; kibuzzard-65BFD82E
kibuzzard-65BFD84C: G***; kibuzzard-65BFD84C
kibuzzard-65BFD746: G***; kibuzzard-65BFD746
kibuzzard-65BFD822: G***; kibuzzard-65BFD822
kibuzzard-65BFD836: G***; kibuzzard-65BFD836
kibuzzard-65BFD865: G***; kibuzzard-65BFD865
kibuzzard-65BFD887: G***; kibuzzard-65BFD887
kibuzzard-65BFD893: G***; kibuzzard-65BFD893
kibuzzard-65BFD905: G***; kibuzzard-65BFD905
kibuzzard-65BFE03F: G***; kibuzzard-65BFE03F
kibuzzard-65BFE052: G***; kibuzzard-65BFE052
kibuzzard-65C3D944: G***; kibuzzard-65C3D944
kibuzzard-65C3E68A: G***; kibuzzard-65C3E68A
kibuzzard-659A3543: G***; kibuzzard-659A3543
kibuzzard-659F41CB: G***; kibuzzard-659F41CB
kibuzzard-659F49E4: G***; kibuzzard-659F49E4
kibuzzard-659F49F4: G***; kibuzzard-659F49F4
kibuzzard-65834FF6: G***; kibuzzard-65834FF6
kibuzzard-658236A5: G***; kibuzzard-658236A5
kibuzzard-658236BF: G***; kibuzzard-658236BF
kibuzzard-658236C5: G***; kibuzzard-658236C5
kibuzzard-658236E5: G***; kibuzzard-658236E5
kibuzzard-658236F2: G***; kibuzzard-658236F2
kibuzzard-658236FD: G***; kibuzzard-658236FD
kibuzzard-6583500B: G***; kibuzzard-6583500B
kibuzzard-65823743: G***; kibuzzard-65823743

Connections:
+3V3: BUZZER201.1 (+), C203.1, C204.1, C205.1, C301.1, C305.1, C701.1, D204.1 (K), D205.1 (K), J801.3, J802.1, J804.1, J805.5, Q801.1 (G), Q802.1 (G), Q803.1 (G), Q804.1 (G), R201.1, R202.1, R203.1, R204.1, R205.1, R206.1, R209.1, R210.1, R213.1, R214.1, R501.1, R605.1, R610.2, R803.1, R804.1, R811.1, R812.1, R814.1, U201.3 (3V3), U301.9 (VDD), U301.18 (~RESET), U701.23 (3V3), U701.24 (3V3)
+5V: C602.1, C609.1, C611.1, C702.1, J405.1, J408.1, J409.1, J410.1, J411.1, J412.1, J413.1, J414.1, J602.5, J604.4, J802.3, J804.3, Q501.4 (E2), Q502.2 (S), R604.1, R702.1, R704.1, R706.1, R708.1, R710.1, R712.1, R714.1, U403.3 (C2), U403.6 (C1), U602.1 (VIN), U701.1 (5V), U701.2 (DIR)
+12V: C601.1, C606.1, C607.1, C610.1, D601.3 (+), J602.2, J604.1, Q805.2 (S), R215.1, R603.1, R820.1, TP601.1, U601.1 (VIN)
/AUX-CONNECTORS/AUX_SCL: J803.1, Q801.3 (D), R807.2
/AUX-CONNECTORS/AUX_SDA: J803.2, Q802.3 (D), R808.2
/AUX-CONNECTORS/AYAB_CIPO: R813.1, U201.15 (GPIO11/TOUCH11/ADC2_CH0/FSPID/FSPIIO5/S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)
/AUX-CONNECTORS/AYAB_COPI: J805.2, U201.16 (GPIO12/TOUCH12/ADC2_CH1/FSPICLK/FSPIIO6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)
/AUX-CONNECTORS/AYAB_CS: J805.1, R814.2, U201.14 (GPIO10/TOUCH10/ADC1_CH9/FSPICS0/FSPIIO4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)
/AUX-CONNECTORS/AYAB_RX: J801.1, R818.2
/AUX-CONNECTORS/AYAB_SCK: J805.4, U201.17 (GPIO13/TOUCH13/ADC2_CH2/FSPIQ/FSPIIO7/S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)
/AUX-CONNECTORS/AYAB_SCL: R209.2, R809.1, U201.13 (GPIO9/TOUCH9/ADC1_CH8/FSPIHD/SUBSPIHD), U301.12 (SCK)
/AUX-CONNECTORS/AYAB_SDA: R210.2, R810.1, U201.12 (GPIO8/TOUCH8/ADC1_CH7/SUBSPICS1), U301.13 (SDA)
/AUX-CONNECTORS/AYAB_TX: J801.2, R819.1
/AUX-CONNECTORS/CIPO: J805.3, R813.2, R815.1
/AUX-CONNECTORS/I2C_SCL: R801.1, U201.20 (GPIO16/U0CTS/ADC2_CH5/XTAL_32K_N)
/AUX-CONNECTORS/I2C_SDA: R802.1, U201.19 (GPIO15/U0RTS/ADC2_CH4/XTAL_32K_P)
/AUX-CONNECTORS/I2C_VBUS: J804.2, J806.3, R816.1, R817.1
/AUX-CONNECTORS/MCP_SCL: J806.1, Q803.3 (D), R816.2
/AUX-CONNECTORS/MCP_SDA: J806.2, Q804.3 (D), R817.2
/AUX-CONNECTORS/UART_RX: R818.1, U201.40 (U0RXD/GPIO44/CLK_OUT2)
/AUX-CONNECTORS/UART_TX: R819.2, U201.39 (U0TXD/GPIO43/CLK_OUT1)
/AUX-CONNECTORS/USER_I2C_VBUS: J802.2, J803.3, R807.1, R808.1
/BROTHER-CONNECTORS/ENC_BELTPHASE: J405.6, J410.5, J413.5, J702.3, R705.1, R706.2, U701.5 (A3)
/BROTHER-CONNECTORS/ENC_V1: J405.4, J410.4, J413.4, J702.1, R701.1, R702.2, U701.3 (A1)
/BROTHER-CONNECTORS/ENC_V2: J405.5, J410.3, J413.3, J702.2, R703.1, R704.2, U701.4 (A2)
/BROTHER-CONNECTORS/EOL_L: J408.3, J411.3, J414.3, R735.1, TP701.1
/BROTHER-CONNECTORS/EOL_R: J409.3, J412.3, R737.1, TP702.1
/BROTHER-CONNECTORS/EOL_R_N: J202.2, J405.8, R213.2, U201.21 (GPIO17/U1TXD/ADC2_CH6)
/BROTHER-CONNECTORS/EOL_R_S: J202.3, J405.7, R214.2, U201.22 (GPIO18/U1RXD/ADC2_CH7/CLK_OUT3)
/BROTHER-CONNECTORS/SOL_0: J401.8, J403.8, J406.8, U303.16 (O1)
/BROTHER-CONNECTORS/SOL_1: J401.7, J403.7, J406.7, U302.10 (O7)
/BROTHER-CONNECTORS/SOL_2: J401.6, J403.6, J406.6, U302.11 (O6)
/BROTHER-CONNECTORS/SOL_3: J401.5, J403.5, J406.5, U302.12 (O5)
/BROTHER-CONNECTORS/SOL_4: J401.4, J403.4, J406.4, U302.13 (O4)
/BROTHER-CONNECTORS/SOL_5: J401.3, J403.3, J406.3, U302.14 (O3)
/BROTHER-CONNECTORS/SOL_6: J401.2, J403.2, J406.2, U302.15 (O2)
/BROTHER-CONNECTORS/SOL_7: J401.1, J403.1, J406.1, U302.16 (O1)
/BROTHER-CONNECTORS/SOL_8: J402.8, J404.8, J407.8, U304.10 (O7)
/BROTHER-CONNECTORS/SOL_9: J402.7, J404.7, J407.7, U304.11 (O6)
/BROTHER-CONNECTORS/SOL_A: J402.6, J404.6, J407.6, U304.12 (O5)
/BROTHER-CONNECTORS/SOL_B: J402.5, J404.5, J407.5, U304.13 (O4)
/BROTHER-CONNECTORS/SOL_C: J402.4, J404.4, J407.4, U304.14 (O3)
/BROTHER-CONNECTORS/SOL_D: J402.3, J404.3, J407.3, U304.15 (O2)
/BROTHER-CONNECTORS/SOL_E: J402.2, J404.2, J407.2, U304.16 (O1)
/BROTHER-CONNECTORS/SOL_F: J402.1, J404.1, J407.1, U303.10 (O7)
/ESP32/BOOT0: R206.2, SW203.1, U201.4 (GPIO0/BOOT)
/ESP32/BOOT1: R207.1, U201.44 (GPIO46)
/ESP32/BUZZER: Q201.1 (G), R211.1, U201.34 (GPIO38/FSPIWP/SUBSPIWP)
/ESP32/ENC_A: J701.1, U201.9 (GPIO5/TOUCH5/ADC1_CH4), U701.21 (B1)
/ESP32/ENC_B: J701.2, U201.10 (GPIO6/TOUCH6/ADC1_CH5), U701.20 (B2)
/ESP32/ENC_BP: J701.3, U201.11 (GPIO7/TOUCH7/ADC1_CH6), U701.19 (B3)
/ESP32/ESP40: J201.2, U201.36 (MTDO/GPIO40/CLK_OUT2)
/ESP32/ESP41: J201.3, U201.37 (MTDI/GPIO41/CLK_OUT1)
/ESP32/ESP42: J201.4, U201.38 (MTMS/GPIO42)
/ESP32/FRONT_PANEL_AUX: J202.1, U201.18 (GPIO14/TOUCH14/ADC2_CH3/FSPIWP/FSPIDQS/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)
/ESP32/GRN: D202.1 (K), U201.29 (SPIIO5/GPIO34/FSPICS0/SUBSPICS0)
/ESP32/HALL_L_ADC: R735.2, R736.1, U201.5 (GPIO1/TOUCH1/ADC1_CH0)
/ESP32/HALL_R_ADC: R737.2, R738.1, U201.6 (GPIO2/TOUCH2/ADC1_CH1)
/ESP32/MACHINE_PWR_SENSE: C206.1, D205.2 (A), D206.1 (K), R215.2, R216.1, U201.8 (GPIO4/TOUCH4/ADC1_CH3)
/ESP32/PANEL_INT: J201.1, U201.35 (MTCK/GPIO39/CLK_OUT3/SUBSPICS1)
/ESP32/RED: D203.1 (K), U201.28 (SPIIO4/GPIO33/FSPIHD/SUBSPIHD)
/ESP32/USB_M: C501.1, J501.A7 (D-), J501.B7 (D-), R501.2, TP502.1, U201.23 (GPIO19/U1RTS/ADC2_CH8/CLK_OUT2/USB_D-), U501.1 (IO1), U501.6 (IO4)
/ESP32/USB_P: C502.1, J501.A6 (D+), J501.B6 (D+), TP503.1, U201.24 (GPIO20/U1CTS/ADC2_CH9/CLK_OUT1/USB_D+), U501.3 (IO2), U501.4 (IO3)
/ESP32/USER_BUTTON: C201.1, R201.2, SW201.1, U201.32 (SPIIO7/GPIO36/FSPICLK/SUBSPICLK)
/ESP32/VCC_SPI: R208.1, U201.41 (GPIO45)
/ESP32/YEL: D201.1 (K), U201.31 (SPIIO6/GPIO35/FSPID/SUBSPID)
/ESP32/nRST: C202.1, R205.2, SW202.1, U201.45 (EN)
/PSU/3V3_SW: C613.1, C615.2, C617.1, C619.1, C621.1, L602.2, R609.2, R610.1, TP603.1
/PSU/5V_SW: C612.1, C614.2, C616.1, C618.1, C620.1, L601.2, R608.2, TP602.1, U403.1 (E1)
/PSU/INP_1: D601.1, J601.1
/PSU/INP_2: D601.2, J601.2, J601.3
/SOLENOID DRIVERS/MCU_SOL_0: U301.8 (GPB7), U303.1 (I1)
/SOLENOID DRIVERS/MCU_SOL_1: U301.7 (GPB6), U302.7 (I7)
/SOLENOID DRIVERS/MCU_SOL_2: U301.6 (GPB5), U302.6 (I6)
/SOLENOID DRIVERS/MCU_SOL_3: U301.5 (GPB4), U302.5 (I5)
/SOLENOID DRIVERS/MCU_SOL_4: U301.4 (GPB3), U302.4 (I4)
/SOLENOID DRIVERS/MCU_SOL_5: U301.3 (GPB2), U302.3 (I3)
/SOLENOID DRIVERS/MCU_SOL_6: U301.2 (GPB1), U302.2 (I2)
/SOLENOID DRIVERS/MCU_SOL_7: U301.1 (GPB0), U302.1 (I1)
/SOLENOID DRIVERS/MCU_SOL_8: U301.21 (GPA0), U304.7 (I7)
/SOLENOID DRIVERS/MCU_SOL_9: U301.22 (GPA1), U304.6 (I6)
/SOLENOID DRIVERS/MCU_SOL_A: U301.23 (GPA2), U304.5 (I5)
/SOLENOID DRIVERS/MCU_SOL_B: U301.24 (GPA3), U304.4 (I4)
/SOLENOID DRIVERS/MCU_SOL_C: U301.25 (GPA4), U304.3 (I3)
/SOLENOID DRIVERS/MCU_SOL_D: U301.26 (GPA5), U304.2 (I2)
/SOLENOID DRIVERS/MCU_SOL_E: U301.27 (GPA6), U304.1 (I1)
/SOLENOID DRIVERS/MCU_SOL_F: U301.28 (GPA7), U303.7 (I7)
/USB/UCPD_CC1: J501.A5 (CC1), R101.1
/USB/UCPD_CC2: J501.B5 (CC2), R102.1
/USB/USB_VBUS: J501.A4 (VBUS), J501.A9 (VBUS), J501.B4 (VBUS), J501.B9 (VBUS), R504.1, TP501.1, U501.5 (VP)
GND: C201.2, C202.2, C203.2, C204.2, C205.2, C206.2, C301.2, C302.2, C303.2, C304.2, C305.2, C501.2, C502.2, C601.2, C602.2, C603.2, C604.2, C605.2, C606.2, C607.2, C609.2, C610.2, C611.2, C612.2, C613.2, C616.2, C617.2, C618.2, C619.2, C620.2, C621.2, C701.2, C702.2, D206.2 (A), D601.4 (-), D602.1 (K), D603.1 (K), D604.1 (K), D605.2 (A), D606.2 (A), H101.1, H102.1, H103.1, H104.1, H106.1, H108.1, J405.2, J408.2, J409.2, J410.2, J411.2, J412.2, J413.2, J414.2, J501.A1 (GND), J501.A12 (GND), J501.B1 (GND), J501.B12 (GND), J501.S1 (SHIELD), J602.3, J602.4, J604.2, J604.3, J801.4, J803.4, J805.6, J806.4, Q201.2 (S), Q806.2 (S), R101.2, R102.2, R207.2, R208.2, R211.2, R216.2, R502.2, R503.2, R606.2, R607.2, R701.2, R703.2, R705.2, R707.2, R709.2, R711.2, R713.2, R736.2, R738.2, R815.2, R822.1, SW201.2, SW202.2, SW203.2, U201.1 (GND), U201.2 (GND), U201.42 (GND), U201.43 (GND), U201.46 (GND), U201.47 (GND), U201.48 (GND), U201.49 (GND), U201.50 (GND), U201.51 (GND), U201.52 (GND), U201.53 (GND), U201.54 (GND), U201.55 (GND), U201.56 (GND), U201.57 (GND), U201.58 (GND), U201.59 (GND), U201.60 (GND), U201.61 (GND), U201.62 (GND), U201.63 (GND), U201.64 (GND), U201.65 (GND), U301.10 (VSS), U301.15 (A0), U301.16 (A1), U301.17 (A2), U302.8 (GND), U303.8 (GND), U304.8 (GND), U403.2 (B1), U403.5 (B2), U501.2 (VN), U601.4 (EN), U601.5 (GND), U601.6 (GND), U601.7 (GND), U601.8 (GND), U602.4 (EN), U602.5 (GND), U602.6 (GND), U602.7 (GND), U602.8 (GND), U701.11 (GND), U701.12 (GND), U701.13 (GND), U701.22 (~OE)
unnamed: D201.2 (A), R202.2
unnamed: D202.2 (A), R203.2
unnamed: D203.2 (A), R204.2
unnamed: BUZZER201.2, D204.2 (A), R212.1
unnamed: D602.2 (A), R603.2
unnamed: D603.2 (A), R604.2
unnamed: D604.2 (A), R605.2
unnamed: D605.1 (K), L601.1, U601.2 (VOUT)
unnamed: D606.1 (K), L602.1, U602.2 (VOUT)
unnamed: J405.9, TP401.1
unnamed: J405.10, TP402.1
unnamed: J701.4, U701.18 (B4)
unnamed: J701.5, U701.17 (B5)
unnamed: J701.6, U701.16 (B6)
unnamed: J701.7, U701.15 (B7)
unnamed: J701.8, U701.14 (B8)
unnamed: J702.4, R707.1, R708.2, U701.6 (A4)
unnamed: J702.5, R709.1, R710.2, U701.7 (A5)
unnamed: J702.6, R711.1, R712.2, U701.8 (A6)
unnamed: J702.7, R713.1, R714.2, U701.9 (A7)
unnamed: J702.8, U701.10 (A8)
unnamed: Q201.3 (D), R212.2
unnamed: Q501.2 (B1), Q501.5 (B2), Q501.6 (C1), R502.1
unnamed: Q501.1 (E1), Q502.3 (D), R504.2
unnamed: Q501.3 (C2), Q502.1 (G), R503.1
unnamed: Q801.2 (S), R801.2, R804.2
unnamed: Q802.2 (S), R802.2, R803.2
unnamed: Q803.2 (S), R809.2, R812.2
unnamed: Q804.2 (S), R810.2, R811.2
unnamed: Q805.1 (G), Q806.3 (D), R820.2
unnamed: Q806.1 (G), R821.2, R822.2
unnamed: TP301.1, U301.20 (INTA)
unnamed: TP302.1, U301.19 (INTB)
unnamed: C614.1, R606.1, R608.1, U601.3 (FB)
unnamed: C615.1, R607.1, R609.1, U602.3 (FB)
SOLENOID_12V_SW: C302.1, C303.1, C304.1, C603.1, C604.1, C605.1, J401.9, J401.10, J403.9, J403.10, J406.9, J406.10, Q805.3 (D), TP703.1, U302.9 (COM), U303.9 (COM), U304.9 (COM)
SOLENOID_PWR_EN: J202.4, R821.1, U201.25 (GPIO21)
