newtonsewingstudio-star/ayab-hardware/(commit log)

2026-09-08 Add scripted KH-910 Rev A KiCad patching
2026-09-08 Add automation to apply Rev A KiCad fixes
2026-09-08 Fix U602 locator for KiCad schematic and PCB
2026-09-08 Use schematic placement to locate U602 reliably
2026-09-08 Fix U602 3.3V regulator metadata [skip ci]
    [ayab-esp32.kicad_pcb, psu.kicad_sch]
2026-09-08 Add Rev A authoritative I/O and pin architecture
2026-09-08 Add Rev A power-domain architecture and state requirements
2026-09-08 Add KiCad ESP32 pin-map auditor
2026-09-08 Add automated Rev A pin-map audit workflow
2026-09-08 Fix pin-audit report commit detection
2026-09-08 Update Rev A MCU pin audit [skip ci]
2026-09-08 Add deterministic Rev A native USB schematic patch
2026-09-08 Route ESP32 native USB to GPIO19/20 [skip ci]
    [mcu.kicad_sch]
2026-09-08 Ensure native USB schematic changes trigger checks
2026-09-08 Update Rev A MCU pin audit
2026-09-08 Add KiCad design validation to Rev A audit
2026-09-08 Fix KiCad symbol-coordinate transform in pin audit
    [audit_esp32_pinmap.py]
2026-09-08 Correct Rev A native USB patch coordinates
    [patch_rev_a_usb.py]
2026-09-08 Route ESP32 native USB to GPIO19/20
    [mcu.kicad_sch]
2026-09-08 Correct Rev A MCU audit findings and module pin notes
2026-09-08 Add validated KH910 K/L schematic patch workflow
2026-09-08 Bypass KH910 K-L comparators and add pull-ups
    [ayab-esp32.kicad_sch, ioconditioning.kicad_sch, mcu.kicad_sch]
2026-09-08 Add staged passive analog Hall ADC patch
2026-09-08 Add validated passive analog Hall patch workflow
2026-09-08 Scope analog Hall postconditions to MCU interface
2026-09-08 Use MCU-scoped analog Hall patch validation
2026-09-08 Mark staged Hall GPIO3/4 opens explicitly for ERC
2026-09-08 Use ERC-clean staged Hall patch
2026-09-08 Add passive analog Hall ADC paths
    [ayab-esp32.kicad_sch, ioconditioning.kicad_sch, mcu.kicad_sch]
2026-09-08 Add Rev A machine power sense patch
2026-09-08 Add validated machine power sense workflow
2026-09-08 Make machine power sense patch top-level robust
2026-09-08 Use robust machine power sense patch
2026-09-08 Define Rev A 5V reverse-current isolation
2026-09-08 Fix machine power sense divider geometry
    [patch_rev_a_machine_power_sense_v3.py]
2026-09-08 Use ERC-correct machine power sense geometry
2026-09-08 Lock LM66100 reverse-blocking pin configuration
2026-09-08 Expose machine power sense hierarchy for validation
2026-09-08 Reuse known-good GPIO4 hierarchy for power sense
2026-09-08 Validate power sense with known-good GPIO4 hierarchy
2026-09-08 Move machine power sense divider into MCU sheet
2026-09-08 Validate local GPIO4 machine power sense
2026-09-08 Lock LM66100 insertion at R406
2026-09-08 Add machine power sensing on GPIO4
    [mcu.kicad_sch]
2026-09-08 Add staged LM66100 5V isolation patch
2026-09-08 Add validated LM66100 5V isolation workflow
2026-09-08 Scope LM66100 patch checks to 5V jumper
2026-09-08 Use coordinate-scoped 5V isolation patch
2026-09-08 Make LM66100 isolation ERC-correct
    [patch_rev_a_5v_isolation_v3.py]
2026-09-08 Add LM66100 machine 5V reverse-current isolation
    [psu.kicad_sch]
2026-09-08 Document Rev A solenoid fail-safe architecture
2026-09-08 Add staged solenoid fail-safe patch
    [patch_rev_a_solenoid_failsafe.py]
2026-09-08 Suppress zero-length fail-safe helper wires
    [patch_rev_a_solenoid_failsafe_v2.py]
2026-09-08 Add solenoid fail-safe validation workflow
2026-09-08 Fix P-MOS gate symbol orientation
    [patch_rev_a_solenoid_failsafe_v3.py]
2026-09-08 Validate corrected solenoid gate geometry
2026-09-08 Add hardware-default-OFF solenoid power gate
    [brother-connectors.kicad_sch, mcu.kicad_sch, solenoids.kicad_sch]
2026-09-08 Add solenoid PCB parity auditor
2026-09-08 Add solenoid PCB parity audit workflow
2026-09-08 Audit solenoid fail-safe PCB parity
2026-09-08 Add solenoid routing geometry audit
2026-09-08 Add solenoid routing geometry audit workflow
2026-09-08 Audit solenoid fail-safe routing geometry
2026-09-08 Add raw 12V bus attachment audit
2026-09-08 Add 12V bus attachment audit workflow
2026-09-08 Audit existing 12V bus attachments
2026-09-08 Add fail-safe placement-space audit
    [audit_rev_a_layout_space.py]
2026-09-08 Audit fail-safe PCB placement space
2026-09-08 Add switched solenoid rail testpoint patch
2026-09-08 Validate switched solenoid rail testpoint
2026-09-08 Add solenoid fail-safe layout corridor audit
    [audit_rev_a_failsafe_layout.py]
2026-09-08 Audit solenoid fail-safe layout corridor
2026-09-08 Add switched solenoid rail test point
    [solenoids.kicad_sch]
2026-09-08 Correct solenoid fail-safe N-MOS orientation
    [patch_rev_a_solenoid_failsafe_v5.py]
2026-09-08 Validate corrected solenoid pull-down orientation
2026-09-08 Complete corrected solenoid fail-safe schematic
    [solenoids.kicad_sch]
2026-09-08 Stage solenoid fail-safe PCB migration
    [patch_rev_a_solenoid_pcb.py]
2026-09-08 Add solenoid fail-safe PCB migration workflow
2026-09-08 Capture solenoid PCB DRC failure diagnostics
2026-09-08 Record rejected solenoid PCB DRC findings
2026-09-08 Capture KiCad solenoid PCB validation output
2026-09-08 Run direct PCB parser before full design checks
2026-09-08 Add staged PCB serialization probe
2026-09-08 Add solenoid PCB parser isolation workflow
2026-09-08 Isolate solenoid PCB serialization failure
2026-09-09 Add progressive solenoid route parser probe
2026-09-09 Probe solenoid routing one primitive at a time
2026-09-09 Pinpoint solenoid PCB route serialization failure
2026-09-09 Fix root-level insertion for solenoid PCB routing
    [patch_rev_a_solenoid_pcb.py]
2026-09-09 Capture full solenoid DRC report before failing
2026-09-09 Add KiCad pcbnew API capability probe
2026-09-09 Probe pcbnew API in GitHub Actions
2026-09-09 Adopt native KiCad API for Rev A PCB edits
2026-09-09 Expand comparator resistor topology audit
2026-09-09 Add staged comparator PCB cleanup probe
2026-09-09 Probe PCB after comparator footprint removal
2026-09-09 Remove obsolete LM393 Hall comparators [skip ci]
    [ioconditioning.kicad_sch]
2026-09-09 Audit Hall comparator PCB parity with pcbnew
2026-09-09 Run native Hall PCB parity audit
2026-09-09 Probe pcbnew footprint and net edit APIs
2026-09-09 Run pcbnew edit API probe
2026-09-09 Refresh Hall PCB parity audit [skip ci]
2026-09-09 Complete pcbnew net edit API probe
2026-09-09 Audit legacy EOL copper paths for Hall ADC migration
2026-09-09 Add native Hall ADC PCB migration tool
2026-09-09 Stage validated Hall ADC PCB migration
2026-09-09 Refresh pcbnew handles after adding Hall nets
2026-09-09 Use direct KiCad pad lookup for Hall PCB migration
2026-09-09 Run Hall PCB migration through direct pad lookup
2026-09-09 Split Hall net creation into reload-safe KiCad pass
2026-09-09 Reload KiCad board after Hall net creation
2026-09-09 Add serialized KiCad Hall audit tool
2026-09-09 Audit serialized Hall targets before PCB migration
2026-09-09 Add deterministic serialized Hall PCB migration
2026-09-09 Run Hall PCB migration through serialized transformer
2026-09-09 Add fast Hall serialized migration smoke gate
2026-09-09 Support legacy KiCad footprint text fields in Hall migration
2026-09-09 Run Hall smoke gate with legacy KiCad compatibility
2026-09-09 Run Hall DRC gate with legacy KiCad compatibility
2026-09-09 Fix Hall ADC net selection in compatibility runner
    [migrate_rev_a_hall_pcb_serialized_compat.py]
2026-09-09 Fix exact Hall ADC copper-count assertions
    [migrate_rev_a_hall_pcb_serialized_compat.py]
2026-09-09 Run staged Hall DRC with full KiCad project context
2026-09-09 Add Hall PCB migration v2 with internal-layer routing
2026-09-09 Add staged KiCad zone refill helper
2026-09-09 Validate Hall PCB v2 with zone refill
2026-09-09 Add Hall legacy route endpoint audit
2026-09-09 Run Hall legacy route audit
2026-09-09 Record Hall legacy route audit [skip ci]
2026-09-09 Add Hall PCB migration v3 with preserved MCU stubs
2026-09-09 Validate Hall PCB migration v3
2026-09-09 Add fast Hall v3 structural smoke gate
2026-09-09 Add targeted Hall local copper audit
2026-09-09 Run targeted Hall local copper audit
2026-09-09 Record Hall local copper audit [skip ci]
2026-09-09 Add board layout debug SVG export
2026-09-09 Fix KiCad 9 layout SVG export
2026-09-09 Add KH910 K-L PCB parity audit
2026-09-09 Run K-L PCB parity with layout export
2026-09-09 Record Rev A layout and K-L PCB audit [skip ci]
2026-09-09 Add Hall PCB migration v4 with connectivity pruning
2026-09-09 Run Hall PCB migration v4 connectivity pruning
2026-09-09 Add Hall PCB v4b DRC-safe routing wrapper
2026-09-09 Run Hall PCB v4b geometric correction
2026-09-09 Stage Hall v4c without guessed cross-board routes
2026-09-09 Add board-aware Hall ADC A-star router
2026-09-09 Route Hall v4c against actual board geometry
2026-09-09 Add narrow Hall v4c residual copper cleanup
2026-09-09 Validate Hall v4c by topology instead of copper count
2026-09-09 Clean residual Hall v4c copper before DRC
2026-09-09 Remove final DRC-proven Hall cleanup stubs
2026-09-09 Identify final Hall stubs by DRC length
2026-09-09 Trim third-wave Hall DRC stubs
2026-09-09 Trim fourth-wave Hall power stubs
2026-09-09 Trim fifth-wave Hall power stubs
2026-09-09 Trim sixth-wave Hall power stubs
2026-09-09 Remove final Hall power tail and via
2026-09-09 Remove exposed Hall power remnants
2026-09-09 Remove final Hall +5V remnants
2026-09-09 Remove last Hall +5V trunk
2026-09-09 Remove final symmetric Hall +5V branch
2026-09-09 Remove last exposed Hall +5V branch
2026-09-09 Remove final Hall +5V tail
2026-09-09 Migrate Hall ADC PCB section to Rev A v4c [skip ci]
    [ayab-esp32.kicad_pcb]
2026-09-09 Audit K-L PCB parity after Hall migration
2026-09-09 Refresh K-L PCB parity audit [skip ci]
2026-09-09 Include PCB snapshot in K-L parity audit artifact
2026-09-09 Add staged K-L PCB electrical migration
2026-09-09 Add K-L staged A-star router
2026-09-09 Add fail-closed K-L PCB migration workflow
2026-09-09 Fix K-L pull-up metadata serialization
    [migrate_rev_a_kl_pcb_stage_v2.py]
2026-09-09 Run robust K-L stage and fail pipelines correctly
2026-09-09 Route K-L through existing board vias
2026-09-09 Fix K-L cleanup net ownership assertions
    [migrate_rev_a_kl_pcb_stage_v4.py]
2026-09-09 Route KH910 K-L with fail-closed candidate paths
    [route_rev_a_kl_astar_v2.py]
2026-09-09 Move KH910 K-L pullups onto valid board area
2026-09-09 Separate K-L text migration from KiCad tail cleanup
2026-09-09 Add KiCad cleanup for K-L legacy tails
2026-09-09 Run KiCad-native final K-L cleanup
2026-09-09 Use KiCad track coordinate accessors for K-L tails
2026-09-09 Migrate KH910 K-L PCB parity to Rev A [skip ci]
    [ayab-esp32.kicad_pcb]
2026-09-09 Add KiCad-native solenoid bus inspector
2026-09-09 Add solenoid bus geometry inspection workflow
2026-09-09 Expand solenoid raw 12V inspection
2026-09-09 Stage DRC-gated solenoid 12V partition
2026-09-09 Add fail-closed solenoid partition stage workflow
2026-09-09 Inspect natural Q805 insertion site
2026-09-09 Handle absent switched net in partition stage
2026-09-09 Run solenoid partition compatibility wrapper
2026-09-09 Fix KiCad track iteration in solenoid partition stage
    [stage_rev_a_solenoid_partition_v2.py]
2026-09-09 Pre-resolve solenoid partition edits before KiCad mutation
    [stage_rev_a_solenoid_partition_v2.py]
2026-09-09 Handle coincident solenoid partition tracks safely
2026-09-09 Open safe In1 solenoid power route corridor
2026-09-09 Redesign solenoid partition around switched local bus
    [stage_rev_a_solenoid_partition_v3.py]
2026-09-09 Validate v3 solenoid switched-bus partition
2026-09-09 Fix v3 partition snapshot boundary
    [stage_rev_a_solenoid_partition_v4.py]
2026-09-09 Run v4 solenoid partition compatibility wrapper
2026-09-09 Accept audited 32-track left solenoid bus
2026-09-09 Run v5 audited solenoid partition
2026-09-09 Fix v5 solenoid wrapper chain
    [stage_rev_a_solenoid_partition_v5.py]
2026-09-09 Speed solenoid partition KiCad CI
2026-09-09 Promote validated solenoid partition
2026-09-09 Apply validated KH910 solenoid power partition
    [ayab-esp32.kicad_pcb]
2026-09-09 Add lower-left solenoid gate placement probe
2026-09-09 Probe lower-left solenoid gate placement
2026-09-09 Document validated solenoid power partition
2026-09-09 Expand solenoid gate placement probe
2026-09-09 Audit compact solenoid gate candidate pockets
2026-09-09 Stage compact lower-left solenoid fail-safe gate
    [stage_rev_a_solenoid_gate_local_v1.py]
2026-09-09 Validate compact solenoid gate stage
2026-09-09 Add staged KH910 solenoid gate layout
2026-09-09 Make gate footprint cloning KiCad 9 safe
2026-09-09 Add solenoid fail-safe PCB topology validator
2026-09-09 Reroute compact solenoid gate pocket
2026-09-09 Move solenoid P-gate routing to In2
2026-09-09 Add obstacle-aware solenoid enable router
2026-09-09 Choose solenoid enable route anchor dynamically
2026-09-09 Add switched-rail TP703 staging router
2026-09-09 Move solenoid enable goal via clear of +5V
2026-09-09 Place enable goal via between inner-layer traces
2026-09-09 Fail solenoid gate CI on DRC violations
2026-09-09 Make solenoid enable goal via all-layer aware
2026-09-09 Use all-layer-aware solenoid enable router
2026-09-09 Stage solenoid switched-rail TP703
2026-09-09 Validate TP703 in solenoid gate stage
2026-09-09 Gate solenoid promotion on topology validation
2026-09-10 Fix TP703 staged placement validation
2026-09-10 Remove orphan I/O conditioning schematic wires
    [ioconditioning.kicad_sch]
2026-09-10 Audit Rev A solenoid gate source
    [solenoids.kicad_sch]
2026-09-10 Integrate Rev A solenoid fail-safe gate
    [ayab-esp32.kicad_pcb]
2026-09-10 Export integrated solenoid gate review views
2026-09-10 Use KiCad 9 compatible gate review export
2026-09-10 Refresh integrated solenoid gate status
2026-09-10 Audit prototype-critical PCB parity
2026-09-10 Audit Rev A power PCB parity
2026-09-10 Run power PCB parity audit on Rev A changes
2026-09-10 Archive power parity audit diagnostics
2026-09-10 Use KiCad XML netlist for power parity audit
2026-09-10 Audit power PCB parity per source sheet
2026-09-10 Resolve active references in power PCB audit
    [audit_rev_a_power_pcb_parity.py]
2026-09-10 Map Rev A power placement before integration
2026-09-10 Trace power integration replacement points
2026-09-10 Probe Rev A power component placement
2026-09-10 Archive power placement evidence on DRC errors
2026-09-10 Probe power placement from board-native footprints
2026-09-10 Parameterize Rev A power placement probe
2026-09-10 Probe Rev A power placement on either board side
2026-09-10 Render power placement candidates for review
2026-09-10 Sweep Rev A power footprints independently
2026-09-10 Stage Rev A power integration on disposable PCB
2026-09-10 Match GPIO4 branch by its fixed endpoints
    [stage_rev_a_power_pcb.py]
2026-09-10 Parse KiCad route blocks in power stage
2026-09-10 Insert staged power net in KiCad net table
2026-09-10 Compare baseline and staged power DRC
2026-09-10 Tie local power-stage nets on reverse side
    [stage_rev_a_power_pcb.py]
2026-09-10 Preserve clearance in local power-stage ties
    [stage_rev_a_power_pcb.py]
2026-09-10 Connect staged five-volt and ground landing points
2026-09-10 Route staged rails around existing ground copper
2026-09-10 Use clear reverse-side path for staged five-volt rail
    [stage_rev_a_power_pcb.py]
2026-09-10 Route staged filtered machine power to load switch
2026-09-10 Bridge filtered-power route over existing rail
2026-09-10 Search board-native corridor for filtered power
2026-09-10 Route staged twelve-volt divider feed separately
2026-09-10 Use inner-layer corridor for staged divider feed
2026-09-10 Stage documented GPIO4 legacy-copper migration
2026-09-10 Route staged sense signal on inner layer
2026-09-10 Probe second inner layer for staged sense route
2026-09-10 Keep staged sense route open pending placement move
2026-09-10 Probe front-layer power-sense routing
2026-09-10 Record power route study failures
    [stage_rev_a_power_pcb.py]
2026-09-10 Use existing 12V spine in power route study
2026-09-10 Stage compact controller-side power sense location
2026-09-10 Probe divider routes across all signal layers
2026-09-10 Complete staged compact power-sense ties
2026-09-10 Reconnect retained generic input in power stage
2026-09-10 Probe all-layer-clear power via escapes
2026-09-10 Route staged power vias through clear escape sites
2026-09-10 Stage divider at verified via-field location
2026-09-10 Use verified GPIO4 via transition in power stage
2026-09-10 Expose power-stage DRC evidence in CI summary
2026-09-10 Publish disposable power-stage DRC evidence
2026-09-10 Record disposable power-stage DRC evidence [skip ci]
2026-09-10 Reuse proven GPIO4 escape in power stage
2026-09-10 Route power divider through isolated pad vias
2026-09-10 Publish power via escape probe
2026-09-10 Record power via escape probe [skip ci]
2026-09-10 Separate divider power escapes
2026-09-10 Move power divider to proven lower corridor
2026-09-10 Assign unique identities to staged footprints
2026-09-10 Space lower power divider footprints
2026-09-10 Route power divider right of control header
2026-09-10 Probe lower power escape corridors
2026-09-10 Widen power-sense route search
2026-09-10 Keep staged sense route out of board keepouts
2026-09-10 Route power sense across clear signal layers
2026-09-10 Promote only a fully clean power-stage board
2026-09-10 Integrate Rev A protected power and sense routing
    [ayab-esp32.kicad_pcb]
2026-09-10 Validate Rev A topology and assembly metadata
    [ayab-esp32.kicad_pcb]
2026-09-10 Keep completed power-stage validation repeatable
2026-09-10 Record Rev A PCB review evidence [skip ci]
2026-09-10 Normalize open pins in power topology audit
2026-09-11 Stage protected GPIO4 machine sense
2026-09-11 Correct protected sense routing and part identity
    [stage_rev_a_machine_sense_protection.py]
2026-09-11 Orient clamp footprints for clear routing
2026-09-11 Clear sense route around ground island
2026-09-11 Integrate protected machine-power sensing
    [ayab-esp32.kicad_pcb, ioconditioning.kicad_sch, mcu.kicad_sch, solenoids.kicad_sch]
2026-09-11 Align clamp polarity and post-integration checks
    [mcu.kicad_sch]
2026-09-11 Match adjustable 3V3 regulator identity
2026-09-11 Close Rev A independent audit repair order
    [aux-connectors.kicad_sch, ayab-esp32.kicad_pcb, ioconditioning.kicad_sch, mcu.kicad_sch, psu.kicad_sch, solenoids.kicad_sch]
2026-09-11 Accept KiCad 9 parity output in CI
2026-09-11 Close final Rev A preorder audit findings
    [ayab-esp32.kicad_pcb, ayab-esp32.kicad_sch, mcu.kicad_sch, psu.kicad_sch, solenoids.kicad_sch, usb.kicad_sch]
2026-09-11 Enforce exact 3D model filename case
    [ayab-esp32.kicad_pcb]
2026-09-11 Close final preorder audit blockers
    [ayab-esp32.kicad_pcb]
2026-09-11 Harden JLC assembly data formatters
2026-09-11 Enforce Rev A assembly population metadata
2026-09-11 Include SMT paste layers in Rev A Gerbers
2026-09-11 Align Rev A drill and silkscreen outputs with assembly guidance
2026-09-12 Document KH910 connector sourcing and assembly paths
2026-09-12 Record KH910 connector sourcing status
2026-09-15 Approve available tin J404 and document display interface
    [ayab-esp32.kicad_pcb, brother-connectors.kicad_sch]
2026-10-18 Start isolated AYAB ESP32-S3 Rev A firmware backup
2026-10-18 Backup Stage 5 beta documentation: BENCH_TEST_PLAN.md
2026-10-18 Backup Stage 5 beta documentation: BUILD_STATUS.md
2026-10-18 Backup Stage 5 beta documentation: HARDWARE_AUDIT.md
2026-10-18 Backup Stage 5 beta documentation: PIN_MAP_AE8F7EB.md
2026-10-18 Backup Stage 5 beta documentation: README.md
2026-10-18 Backup Stage 5 beta: platformio.ini
2026-10-18 Backup Stage 5 beta: src/reva_pins.h
2026-10-18 Backup Stage 5 beta: src/reva_i2c.h
2026-10-18 Backup Stage 5 beta: src/reva_inputs.h
2026-10-18 Backup Stage 5 beta: src/bench_session.h
2026-10-18 Backup Stage 5 beta: src/protocol.h
2026-10-18 Backup Stage 5 beta: src/main.cpp
2026-10-18 Backup Stage 5 beta: tests/test_reva_pins.cpp
2026-10-18 Backup Stage 5 beta: tests/test_bench_session.cpp
2026-10-18 Backup Stage 5 beta: tests/test_stage3.cpp
2026-10-18 Backup Stage 5 beta: tests/test_native.cpp
2026-10-18 Backup Stage 5 beta: tests/test_protocol.py
2026-10-18 Backup Stage 5 beta: tests/test_probe.py
2026-10-18 Backup Stage 5 beta: tests/probe_usb.py
2026-10-18 Backup Stage 5 beta: tests/test_bench_session.py
2026-10-18 Preserve Stage 5 source newline: README.md
2026-10-18 Preserve Stage 5 source newline: BENCH_TEST_PLAN.md
2026-10-18 Preserve Stage 5 source newline: BUILD_STATUS.md
2026-10-18 Preserve Stage 5 source newline: HARDWARE_AUDIT.md
2026-10-18 Preserve Stage 5 source newline: PIN_MAP_AE8F7EB.md
2026-10-18 Preserve Stage 5 source newline: platformio.ini
2026-10-18 Preserve Stage 5 source newline: src/reva_pins.h
2026-10-18 Preserve Stage 5 source newline: src/reva_i2c.h
2026-10-18 Preserve Stage 5 source newline: src/reva_inputs.h
2026-10-18 Preserve Stage 5 source newline: src/bench_session.h
2026-10-18 Preserve Stage 5 source newline: src/protocol.h
2026-10-18 Preserve Stage 5 source newline: src/main.cpp
2026-10-18 Preserve Stage 5 source newline: tests/test_reva_pins.cpp
2026-10-18 Preserve Stage 5 source newline: tests/test_bench_session.cpp
2026-10-18 Preserve Stage 5 source newline: tests/test_stage3.cpp
2026-10-18 Preserve Stage 5 source newline: tests/test_native.cpp
2026-10-18 Preserve Stage 5 source newline: tests/test_protocol.py
2026-10-18 Preserve Stage 5 source newline: tests/test_probe.py
2026-10-18 Preserve Stage 5 source newline: tests/probe_usb.py
2026-10-18 Preserve Stage 5 source newline: tests/test_bench_session.py
2026-10-18 Label Stage 5 ESP32-S3 firmware as experimental beta
