newtonsewingstudio-star/ayab-hardware/(notices)

Notices in the files:
ayab-esp32/mcu.kicad_sch:
distributed under CC-BY-SA-4.0
